nirban/MIDIFootController/Images/sys.png

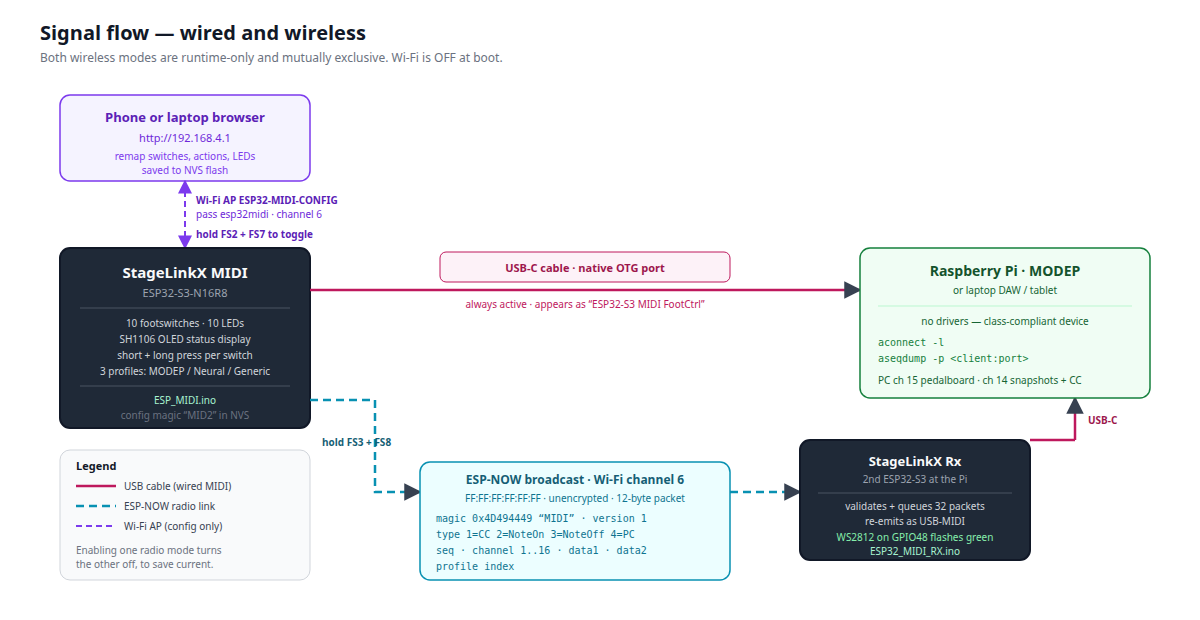
Images/sys.png
